IFJ88/2025-J5-Brazo-Robotico-Seguro/(commit log)

2025-10-09 [docs] Se agregó un borrador del sistema de anticolisiones propuesto por el grupo.
2025-10-09 [hotfix] arreglos en la nomenclatura para expresiones matemáticas
2025-11-01 Codigo funcional de python
2025-11-08 Rotaciones fijas de cada eslabon + rotaciones para E0 y E3
2025-11-10 Cambios en los comentarios de los archivos
2025-11-10 [Refactor] Se crearon los vectores SALTO_ESLABONES para independizar a las esferas con el cálculo de la longitud de los eslabones.
2025-11-13 [Refactor] Se realizaron cambios en la definicion de los vectores
2025-11-13 Implementación de matriz anticolion (Por chequear) + Simulacion mas dinamica con eleccion de eslabon y angulo + chequeo de colsion con z=0
2025-11-15 Ajuste manejo de angulos para cada eslabon + codigo de mapeo y manejo de servos en C
2025-11-15 codigo de mapeo y manejo de servos en C
2025-11-15 Updates de codigo en C
2025-11-21 IDLE + Sincronizacion de potenciometro + limites fisicos
2025-12-05 Update Vista 3D + ajuste pin servos + ajuste calibracion de pulso + update idle
2025-12-06 Ajustes vista de simulación
2025-12-08 Ulitmo Update de posicion home
